IMSB/FlyCatwalk/README.md

FlyCatwalk
==========
This repository contains basic documentation, drawings and code for the **FlyCatwalk**, which was originally developed as a collaboration between the [Institute of Molecular Systems Biology](http://www.imsb.ethz.ch/) at [ETH Zürich](http://www.ethz.ch) and [Scitracks GmbH](http://www.scitracks.com/) 

### License
The **FlyCatwalk** package is licensed by [ETH Zürich](http://www.ethz.ch) under [GPLv3 license](http://www.gnu.org/copyleft/gpl.html)
