IMSB/FlyCatwalk/hardware/README.md

Hardware
==========
Contains the cad files and the schematics of the arduino extensions required to build the flycatwalk.
The cutting work was done with a laser cutter.

### License
The **FlyCatwalk** package is licensed by [ETH Zürich](http://www.ethz.ch) under [GPLv3 license](http://www.gnu.org/copyleft/gpl.html)
