IMSB/FlyCatwalk/software/image processing C++ dll for labview/labview code/notEnough.png

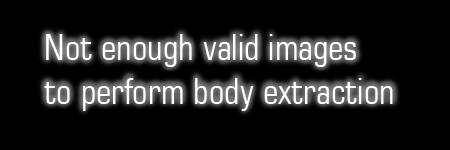
software/image processing C++ dll for labview/labview code/notEnough.png
