IMSB/FlyCatwalk/software/matlab/waitCatWalk.png

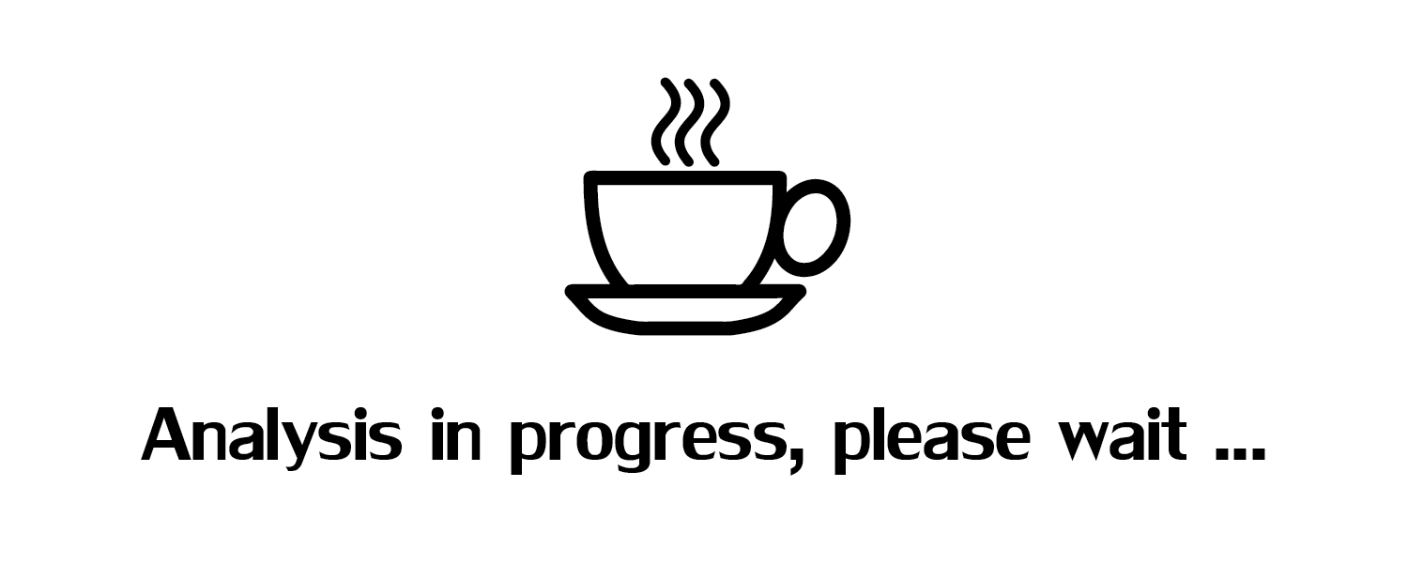
software/matlab/waitCatWalk.png
