IMSB/FlyCatwalk/software/matlab/welcomeCatWalk.png

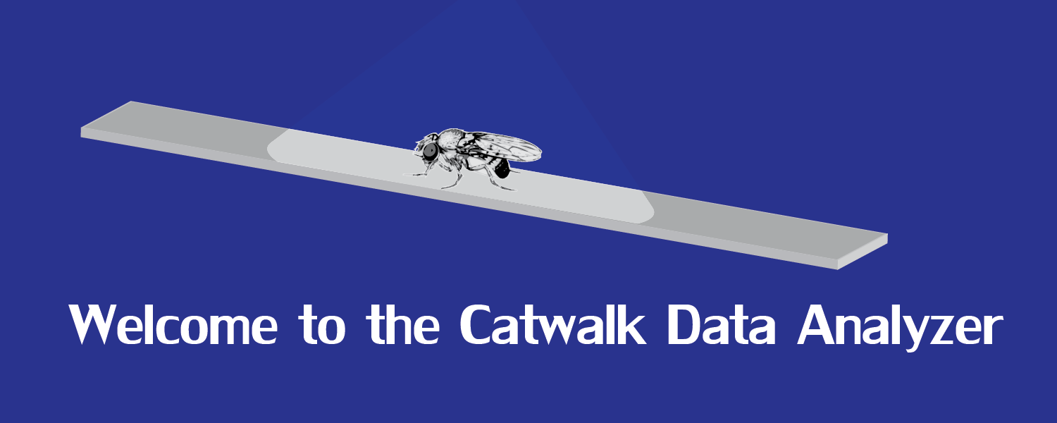
software/matlab/welcomeCatWalk.png
