IMSB/FlyCatwalk/hardware/cad drawings/hangar/flyHolderToRobotLock.stp

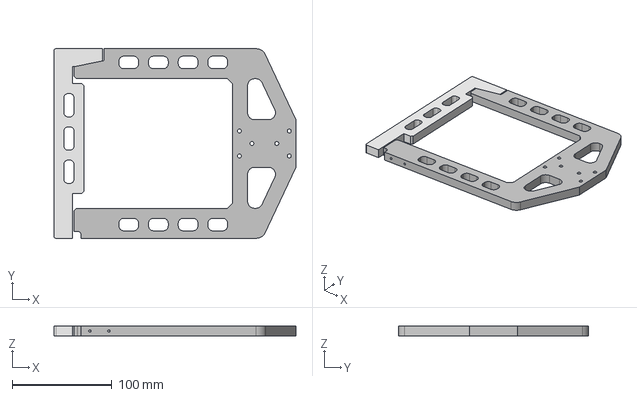
[picture p7: CAD file, 2014-11-16]
hardware/cad drawings/hangar/flyHolderToRobotLock.stp
242.5 x 190.0 x 10.0 mm
flyHolderToRobotLock
flyHolderToRobotLock2
