IMSB/FlyCatwalk/hardware/cad drawings/tunnel/blowin2.stp

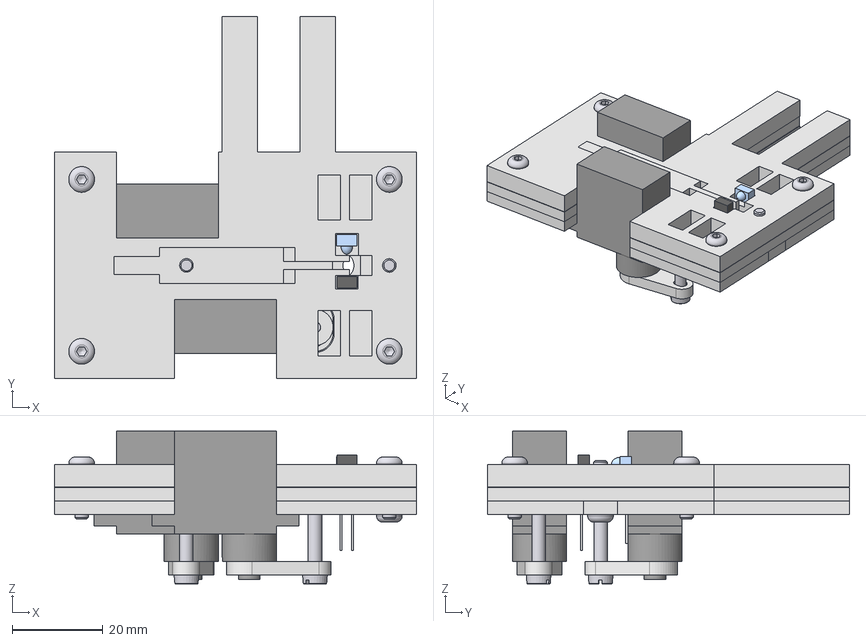
[picture p8: CAD file, 2014-11-16]
hardware/cad drawings/tunnel/blowin2.stp
80.0 x 80.0 x 33.8 mm
blowin4b
blowin3b
blowin5b
blowin1b
blowin2.15
servo x 2
blowin2.16
decollator3.6
decollator3.7
IRLed
photodiode
DIN 84 - replaced by DIN EN ISO 1207 M3 x 25
DIN 84 - replaced by DIN EN ISO 1207 M3 x 18
JIS B 1174 - Metric M3 x 12 x 5
blowin11
