IMSB/FlyCatwalk/hardware/arduino extensions/eagle/arduinoModuleSVS/arduinoModuleSVS.brd

## EAGLE design hardware/arduino extensions/eagle/arduinoModuleSVS/arduinoModuleSVS.brd (2014-11-16)

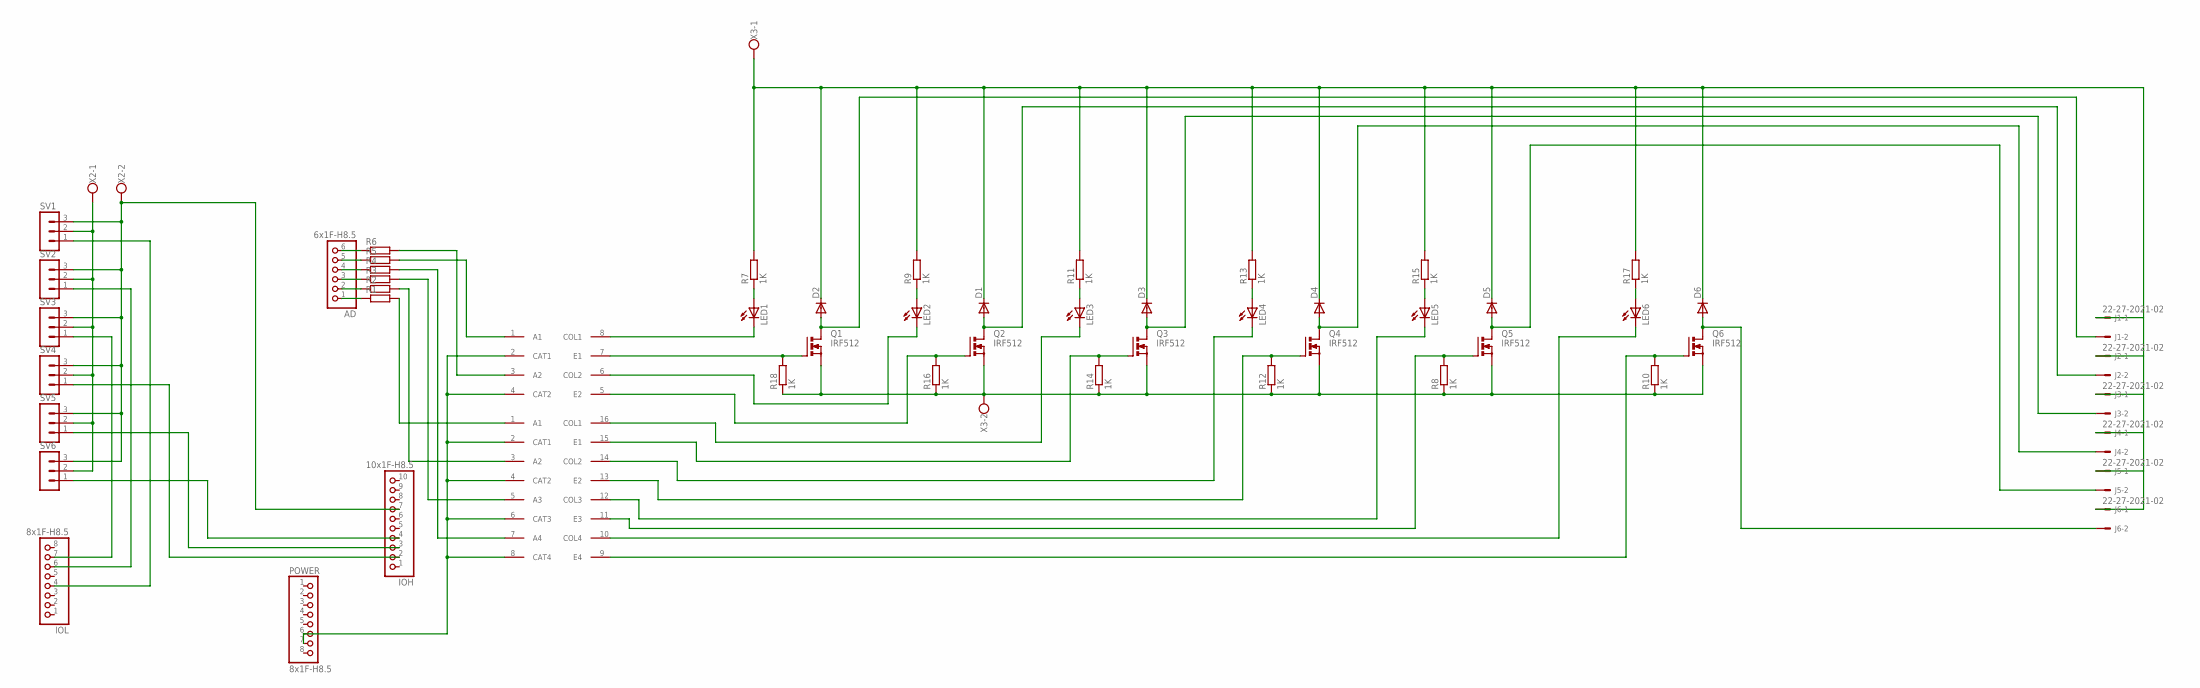
[picture p9: schematic arduinoModuleSVS.sch]

Parts:
AD: 6x1F-H8.5; SMARTPRJ_1X06
D1, D2, D3, D4, D5, D6: DIODE-SOD123; SOD123
IOH: 10x1F-H8.5; SMARTPRJ_1X10
IOL: 8x1F-H8.5; SMARTPRJ_1X08
J1, J2, J3, J4, J5, J6: 22-27-2021-02; 6410-02
LED1, LED2, LED3, LED4, LED5, LED6: LED3MM
POWER: 8x1F-H8.5; SMARTPRJ_1X08
Q1, Q2, Q3, Q4, Q5, Q6: IRF512; TO220BV
R1, R2, R3, R4, R5, R6: R-EU_R0805; R0805
R7, R8, R9, R10, R11, R12, R13, R14, R15, R16, R17, R18: 1K; R0805
SV1, SV2, SV3, SV4, SV5, SV6: MA03-1
U$1: ACPL-847-W00E; DIL16
U$2: ACPL-827-00CE; DIL08
X2, X3: W237-102

Connections:
GND: POWER.6, POWER.7, U$1.2 (CAT1), U$1.4 (CAT2), U$1.6 (CAT3), U$1.8 (CAT4), U$2.2 (CAT1), U$2.4 (CAT2)
GND24V: Q1.S, Q2.S, Q3.S, Q4.S, Q5.S, Q6.S, R8.1, R10.1, R12.1, R14.1, R16.1, R18.1, X3.2
GNDARDUINO: IOH.7, SV1.3, SV2.3, SV3.3, SV4.3, SV5.3, SV6.3, X2.2
unnamed: IOL.4, SV1.1
unnamed: IOL.6, SV2.1
unnamed: IOL.7, SV3.1
unnamed: IOH.2, SV4.1
unnamed: IOH.3, SV5.1
unnamed: IOH.4, SV6.1
unnamed: R1.2, U$1.1 (A1)
unnamed: R2.2, U$1.3 (A2)
unnamed: R3.2, U$1.5 (A3)
unnamed: AD.1, R1.1
unnamed: R4.2, U$1.7 (A4)
unnamed: AD.2, R2.1
unnamed: AD.3, R3.1
unnamed: AD.4, R4.1
unnamed: R6.2, U$2.3 (A2)
unnamed: R5.2, U$2.1 (A1)
unnamed: AD.6, R6.1
unnamed: AD.5, R5.1
unnamed: Q1.G, R18.2, U$2.7 (E1)
unnamed: D2.A, J1.2, Q1.D
unnamed: LED2.K (C), U$2.6 (COL2)
unnamed: LED2.A, R9.1
unnamed: Q2.G, R16.2, U$2.5 (E2)
unnamed: LED1.K (C), U$2.8 (COL1)
unnamed: D1.A, J2.2, Q2.D
unnamed: LED1.A, R7.1
unnamed: LED3.K (C), U$1.16 (COL1)
unnamed: LED3.A, R11.1
unnamed: Q3.G, R14.2, U$1.15 (E1)
unnamed: D3.A, J3.2, Q3.D
unnamed: LED4.K (C), U$1.14 (COL2)
unnamed: LED4.A, R13.1
unnamed: Q4.G, R12.2, U$1.13 (E2)
unnamed: D4.A, J4.2, Q4.D
unnamed: LED5.K (C), U$1.12 (COL3)
unnamed: LED5.A, R15.1
unnamed: Q5.G, R8.2, U$1.11 (E3)
unnamed: D5.A, J5.2, Q5.D
unnamed: LED6.K (C), U$1.10 (COL4)
unnamed: LED6.A, R17.1
unnamed: Q6.G, R10.2, U$1.9 (E4)
unnamed: D6.A, J6.2, Q6.D
VCC6V: SV1.2, SV2.2, SV3.2, SV4.2, SV5.2, SV6.2, X2.1
VCC24: D1.C, D2.C, D3.C, D4.C, D5.C, D6.C, J1.1, J2.1, J3.1, J4.1, J5.1, J6.1, R7.2, R9.2, R11.2, R13.2, R15.2, R17.2, X3.1

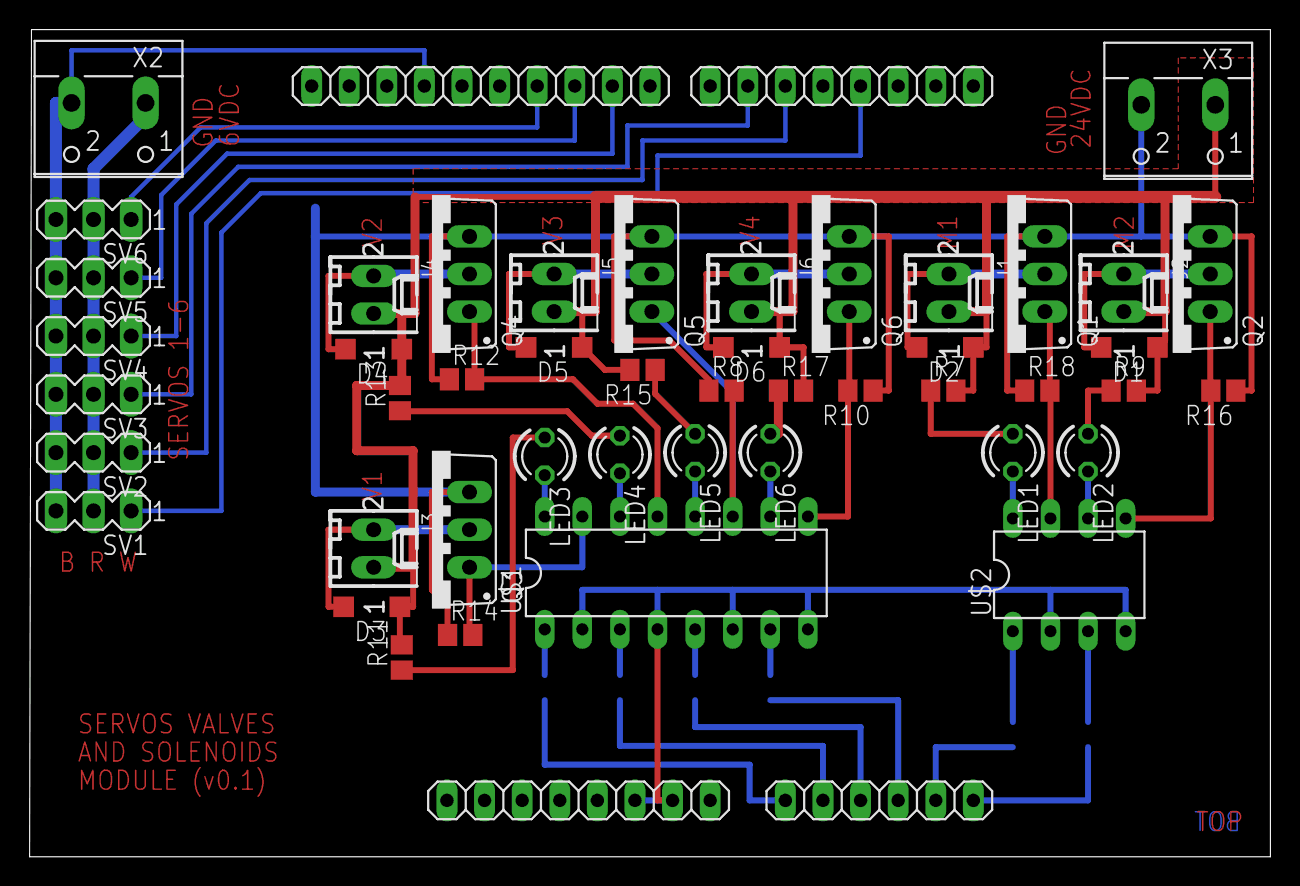
[picture p10: board arduinoModuleSVS.brd from above]

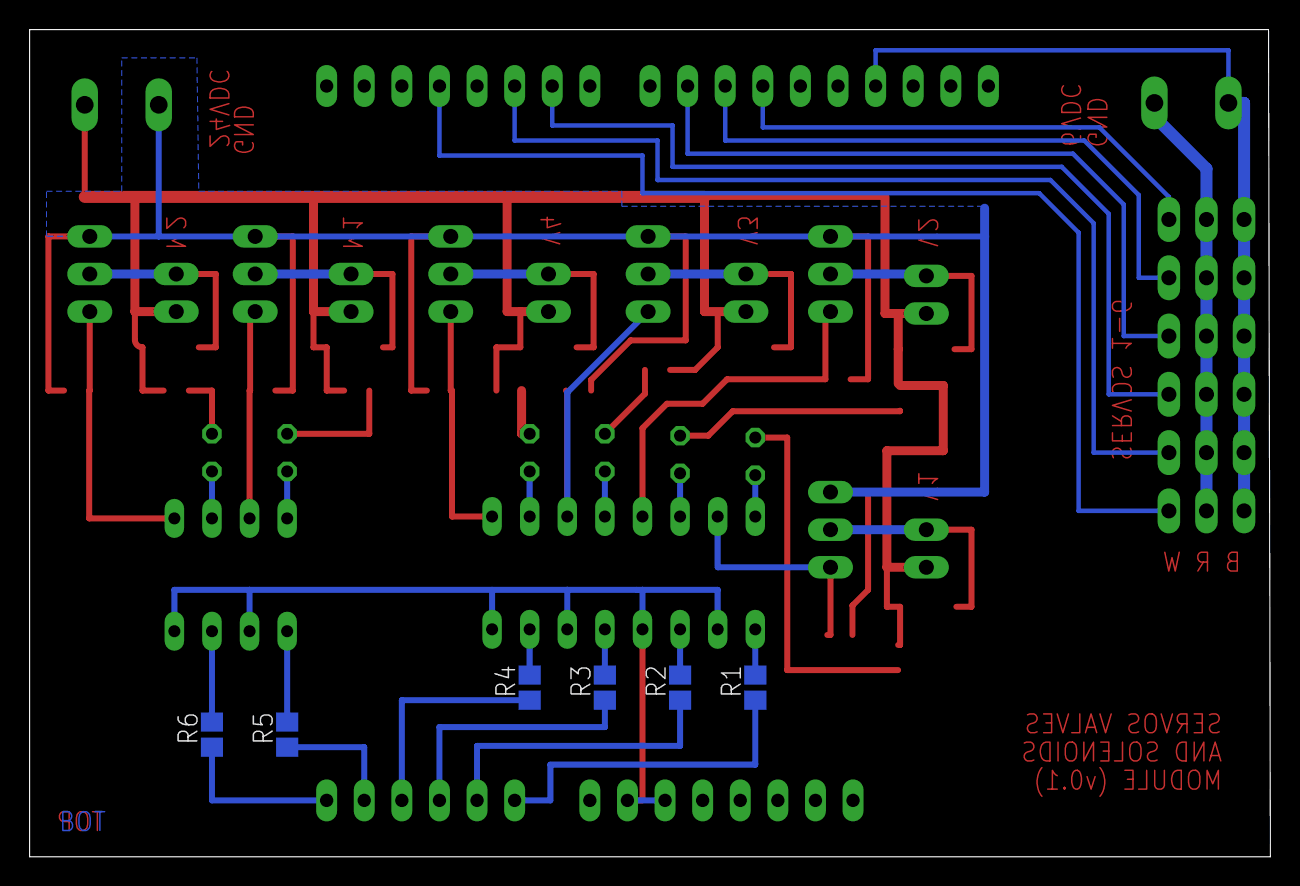
[picture p11: board arduinoModuleSVS.brd from below]

Board: 2 copper layers, 83.8 x 55.9 mm, 56 parts (6 on the bottom side), 47 nets.
