IMSB/FlyCatwalk/hardware/arduino extensions/eagle/arduinoModuleLB/arduinoModuleLB.brd

## EAGLE design hardware/arduino extensions/eagle/arduinoModuleLB/arduinoModuleLB.brd (2014-11-16)

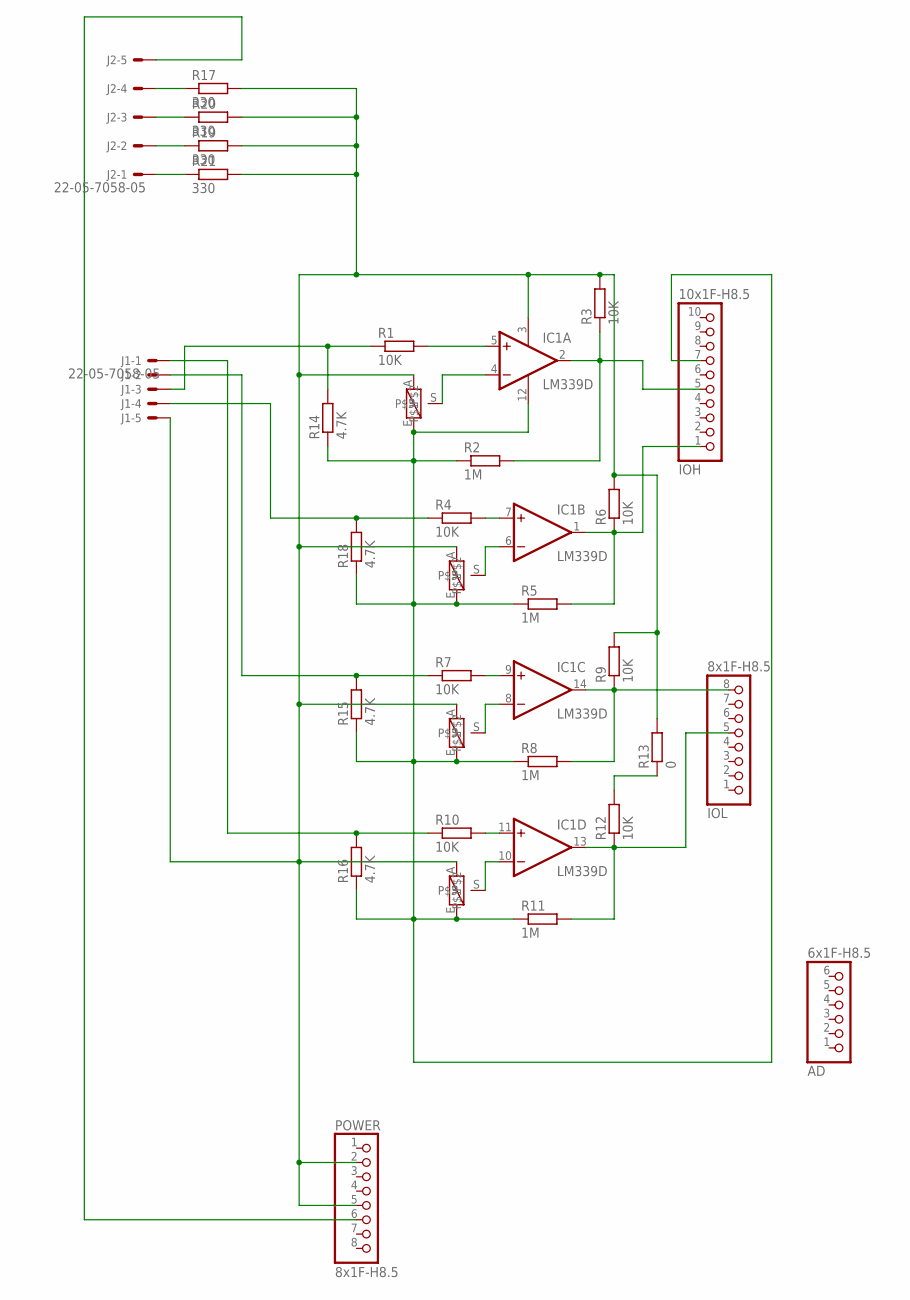
[picture p12: schematic arduinoModuleLB.sch]

Parts:
AD: 6x1F-H8.5; SMARTPRJ_1X06
IC1: LM339D; SO14
IOH: 10x1F-H8.5; SMARTPRJ_1X10
IOL: 8x1F-H8.5; SMARTPRJ_1X08
J1, J2: 22-05-7058-05; 7395-05
POWER: 8x1F-H8.5; SMARTPRJ_1X08
R1, R3, R4, R6, R7, R9, R10, R12: 10K; R0603
R2, R5, R8, R11: 1M; R0603
R13: 0; 0207/10
R14, R15, R16, R18: 4.7K; 0207/10
R17, R19, R20, R21: 330; R0603
U$3, U$4, U$5, U$6: M64P103KB40; M64P

Connections:
5V: IC1.3 (V+), J1.5, POWER.2, POWER.5, R3.2, R6.2, R9.2, R13.2, R17.2, R19.2, R20.2, R21.2, U$3.A, U$4.A, U$5.A, U$6.A
GND: IC1.12 (GND), IOH.7, R2.1, R5.1, R8.1, R11.1, R14.1, R15.1, R16.1, R18.1, U$3.E, U$4.E, U$5.E, U$6.E
unnamed: IC1.4 (-IN), U$4.S
unnamed: IC1.5 (+IN), R1.2
unnamed: IC1.2 (OUT), IOH.5, R2.2, R3.1
unnamed: J1.3, R1.1, R14.2
unnamed: IC1.7 (+IN), R4.2
unnamed: IC1.6 (-IN), U$3.S
unnamed: IC1.1 (OUT), IOH.1, R5.2, R6.1
unnamed: J1.4, R4.1, R18.2
unnamed: IC1.8 (-IN), U$5.S
unnamed: IC1.14 (OUT), IOL.8, R8.2, R9.1
unnamed: IC1.10 (-IN), U$6.S
unnamed: J1.2, R7.1, R15.2
unnamed: IC1.9 (+IN), R7.2
unnamed: IC1.13 (OUT), IOL.5, R11.2, R12.1
unnamed: J1.1, R10.1, R16.2
unnamed: R12.2, R13.1
unnamed: IC1.11 (+IN), R10.2
unnamed: J2.4, R17.1
unnamed: J2.3, R20.1
unnamed: J2.2, R19.1
unnamed: J2.1, R21.1
unnamed: J2.5, POWER.6

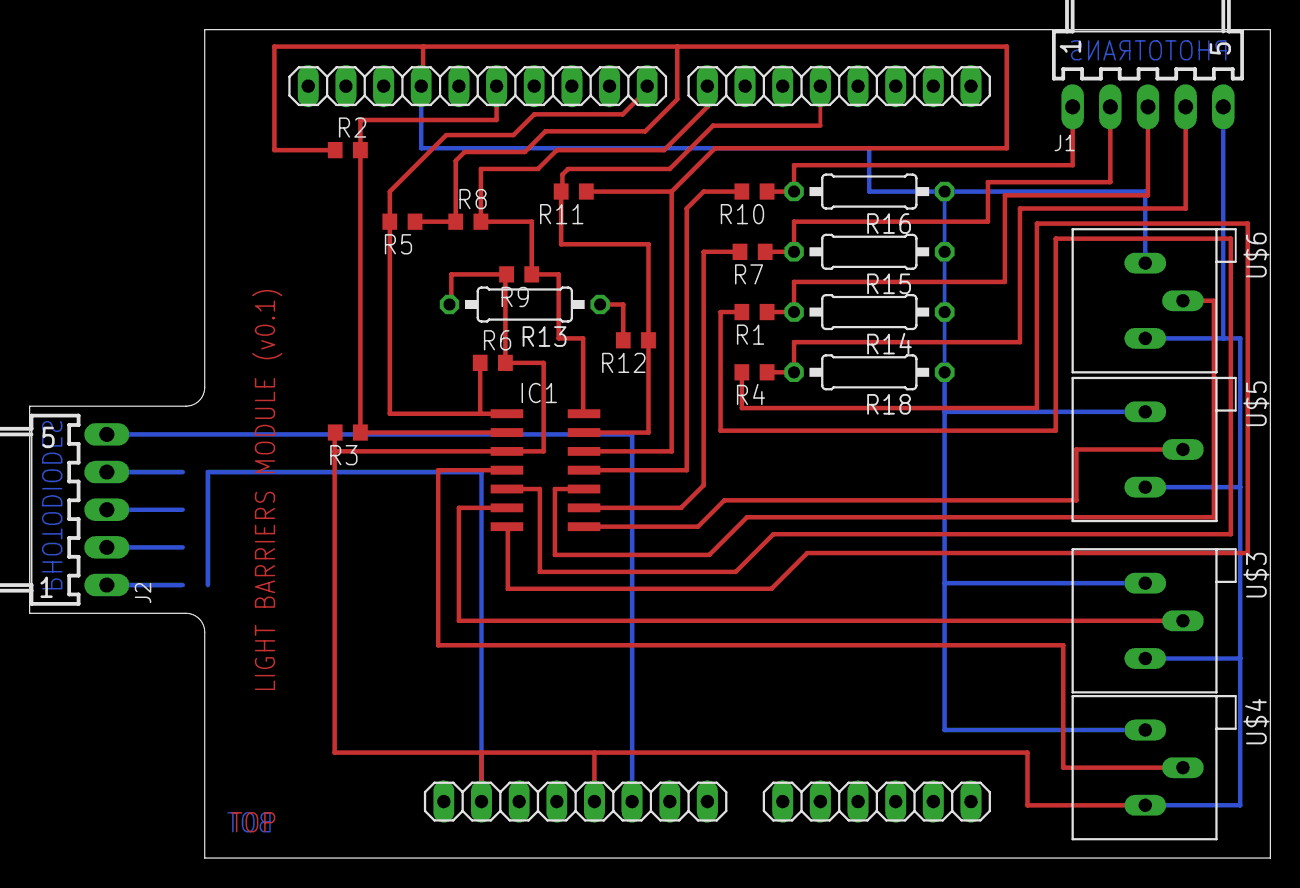
[picture p13: board arduinoModuleLB.brd from above]

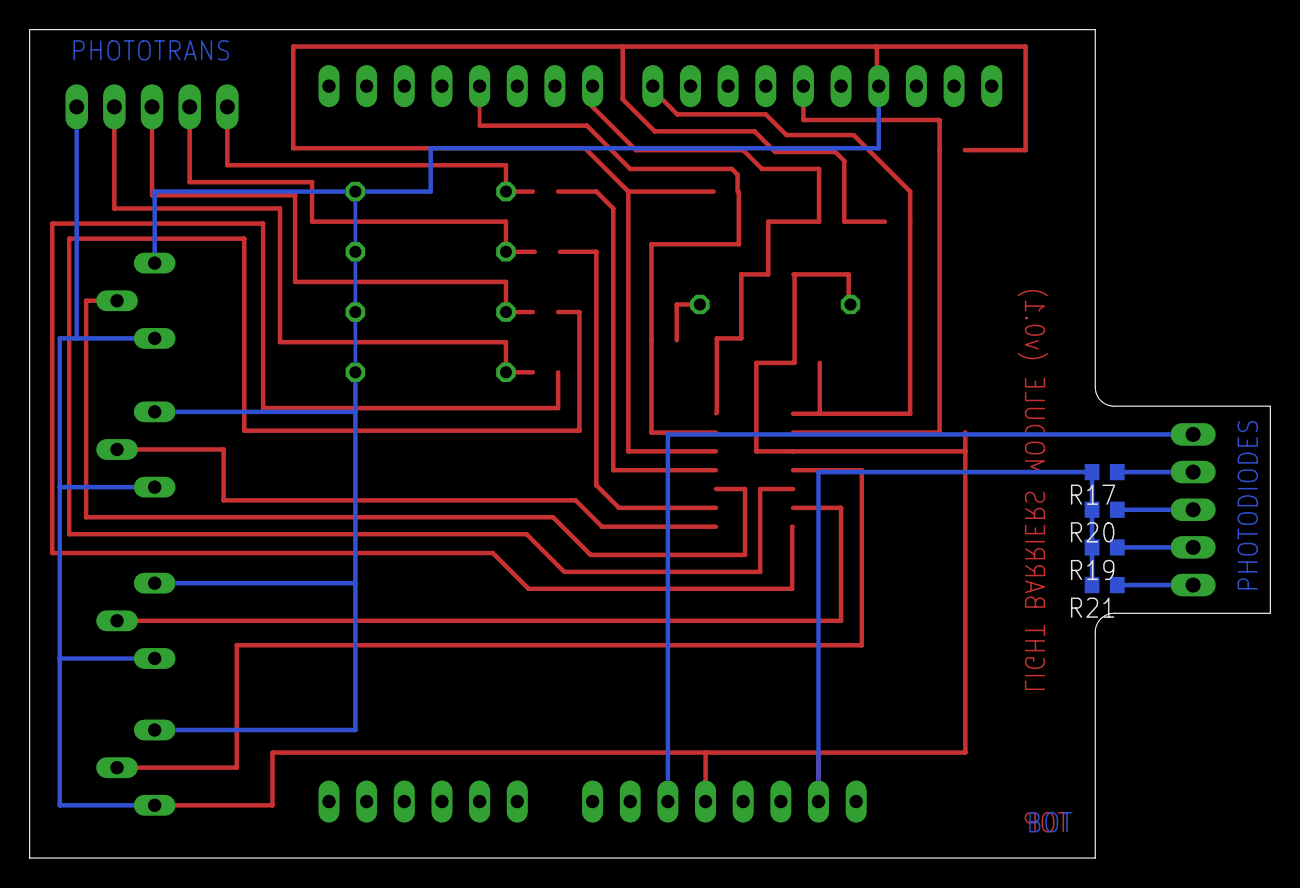
[picture p14: board arduinoModuleLB.brd from below]

Board: 2 copper layers, 83.7 x 55.9 mm, 32 parts (4 on the bottom side), 24 nets.
